RWeick/Datel-Gameboy-Pro-Action-Replay/README.md

# Datel-Gameboy-Pro-Action-Replay
Everything necessary to produce the Pro Action Replay for the Gameboy.

PCB Thickness: 0.8 mm

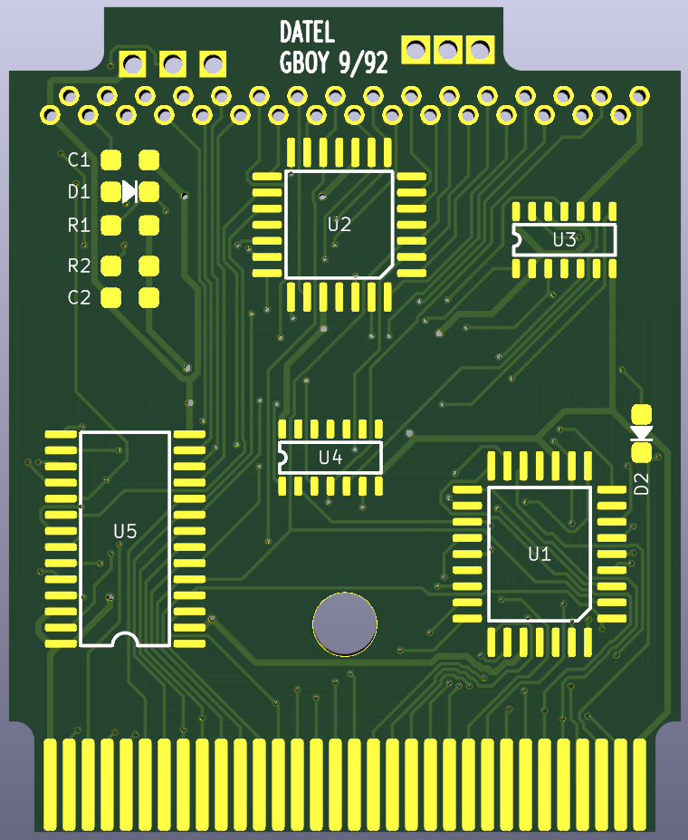
[picture p1: GBOY.png]
