RWeick/Datel-Gameboy-Pro-Action-Replay/GBOY.kicad_pcb

## KiCad design GBOY.kicad_pcb (2024-09-15)

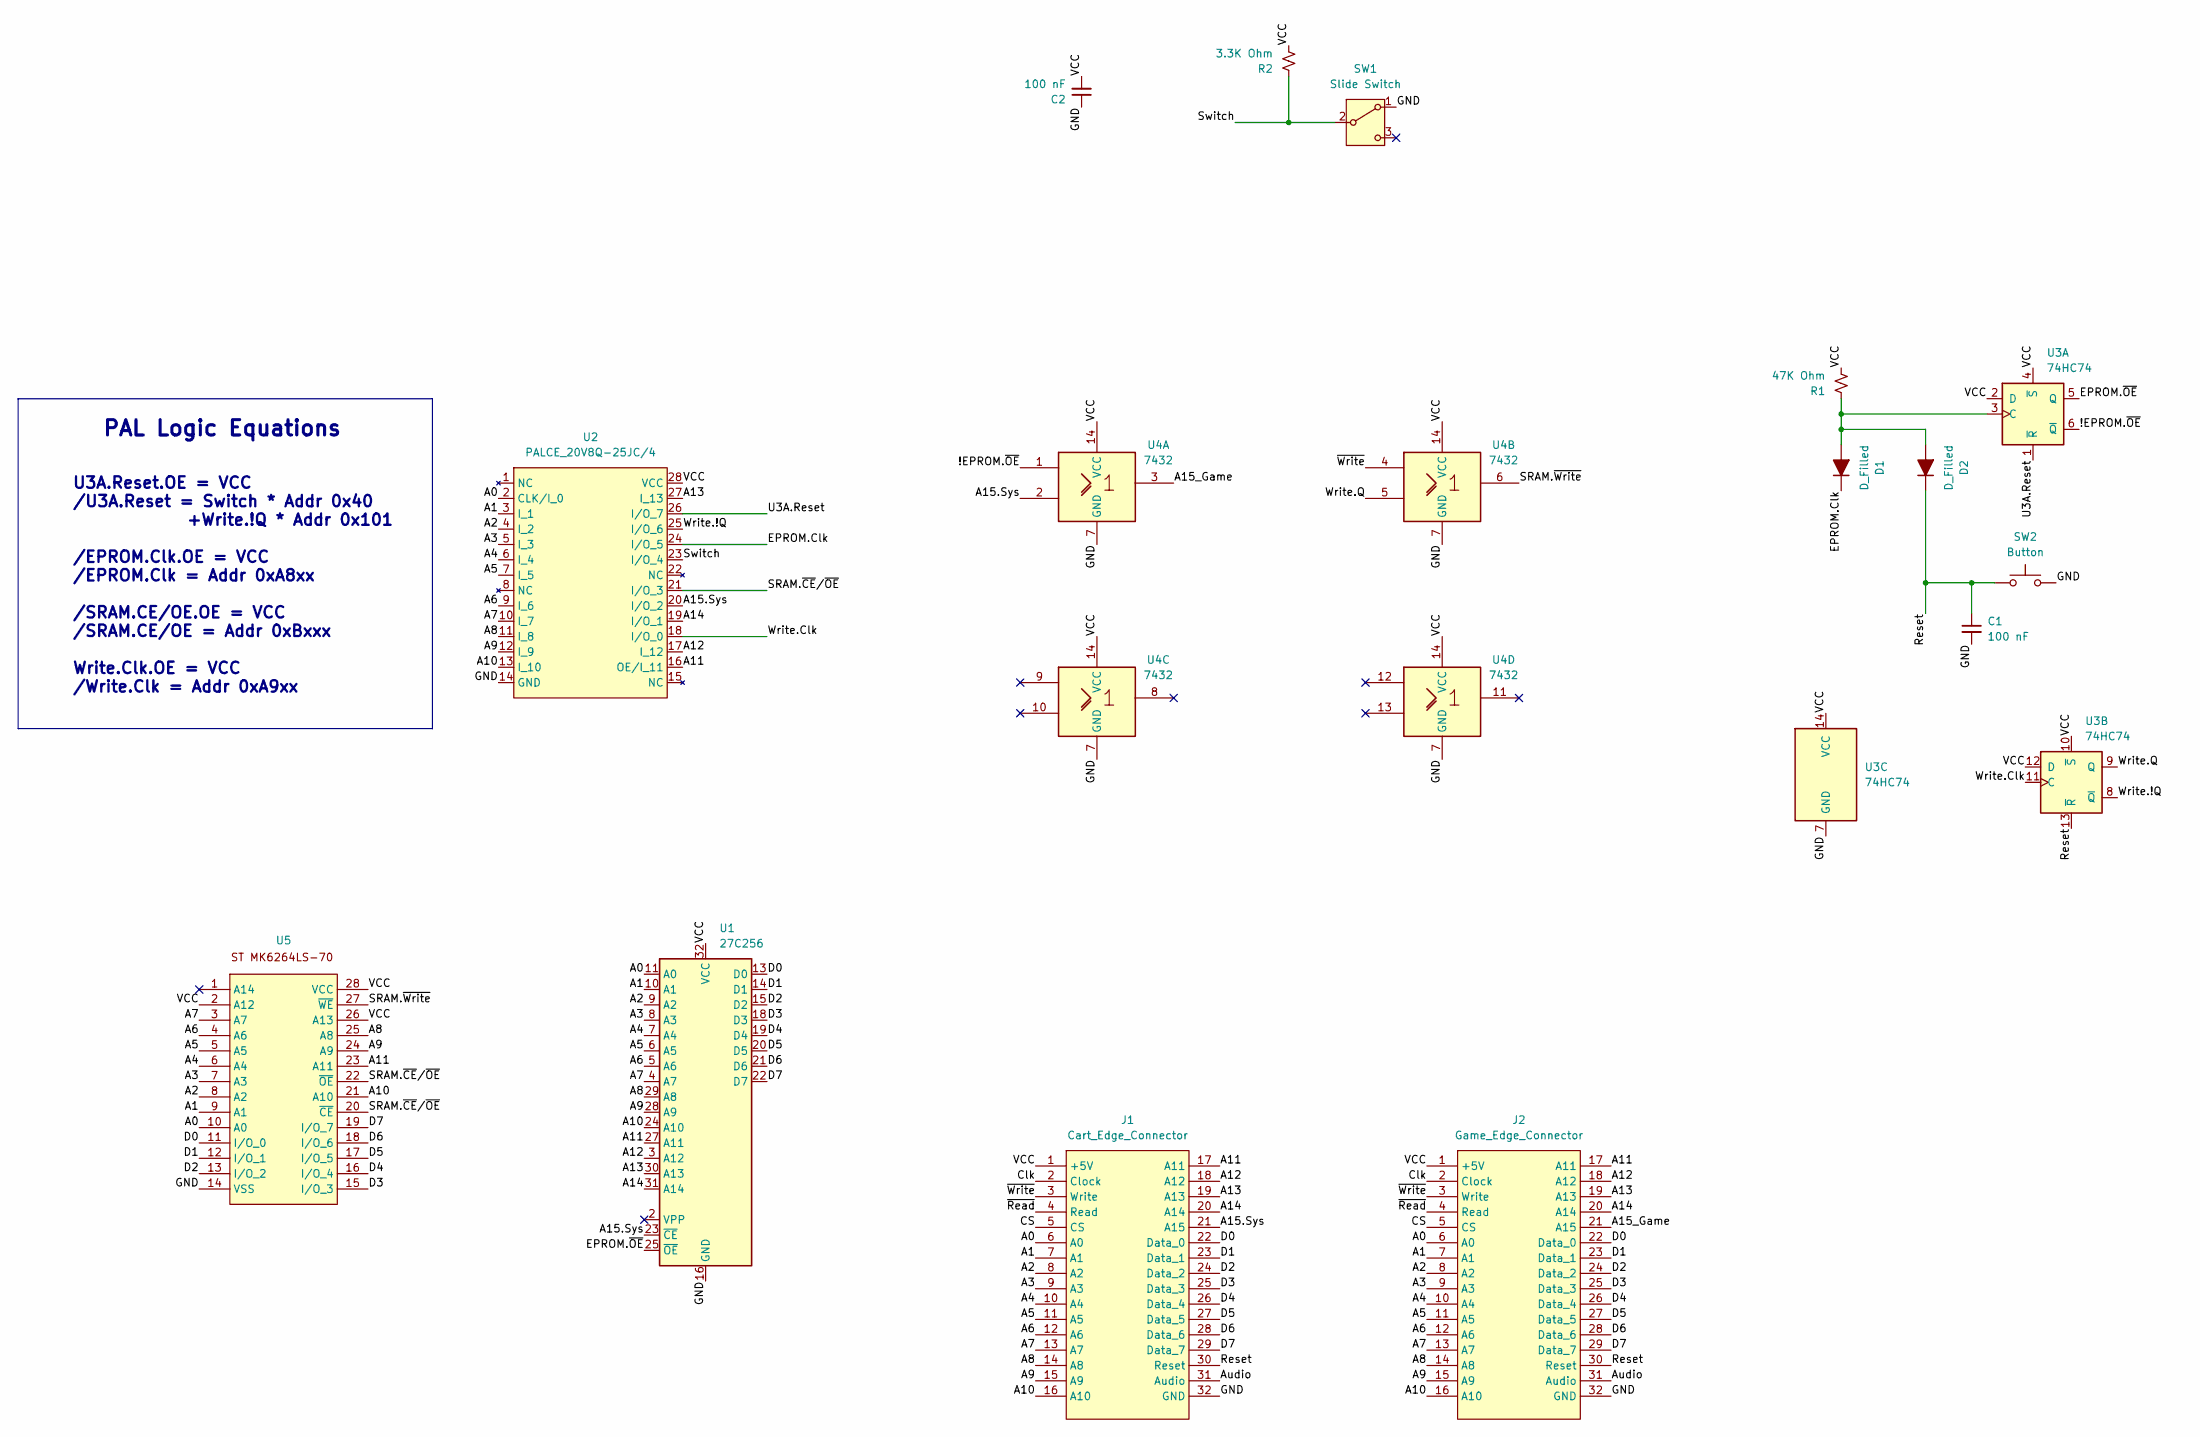
[picture p2: schematic GBOY.kicad_sch]

Parts:
C1, C2: 100 nF; 1206 SMD
D1, D2: D_Filled; 1206 SMD
J1: Cart_Edge_Connector; Edge Connector
J2: Game_Edge_Connector; Cartridge Slot
R1: 47K Ohm; 1206 SMD
R2: 3.3K Ohm; 1206 SMD
SW1: Slide Switch; Switch
SW2: Button
U1: 27C256; EPROM
U2: PALCE_20V8Q-25JC/4; PALCE
U3: 74HC74; SOIC-14
U4: 7432; SOIC-14
U5: SRAM

Connections:
/!EPROM.~OE: U3.6 (~Q), U4.1
/A0: J1.6 (A0), J2.6 (A0), U1.11 (A0), U2.2 (CLK/I_0), U5.10 (A0)
/A1: J1.7 (A1), J2.7 (A1), U1.10 (A1), U2.3 (I_1), U5.9 (A1)
/A2: J1.8 (A2), J2.8 (A2), U1.9 (A2), U2.4 (I_2), U5.8 (A2)
/A3: J1.9 (A3), J2.9 (A3), U1.8 (A3), U2.5 (I_3), U5.7 (A3)
/A4: J1.10 (A4), J2.10 (A4), U1.7 (A4), U2.6 (I_4), U5.6 (A4)
/A5: J1.11 (A5), J2.11 (A5), U1.6 (A5), U2.7 (I_5), U5.5 (A5)
/A6: J1.12 (A6), J2.12 (A6), U1.5 (A6), U2.9 (I_6), U5.4 (A6)
/A7: J1.13 (A7), J2.13 (A7), U1.4 (A7), U2.10 (I_7), U5.3 (A7)
/A8: J1.14 (A8), J2.14 (A8), U1.29 (A8), U2.11 (I_8), U5.25 (A8)
/A9: J1.15 (A9), J2.15 (A9), U1.28 (A9), U2.12 (I_9), U5.24 (A9)
/A10: J1.16 (A10), J2.16 (A10), U1.24 (A10), U2.13 (I_10), U5.21 (A10)
/A11: J1.17 (A11), J2.17 (A11), U1.27 (A11), U2.16 (OE/I_11), U5.23 (A11)
/A12: J1.18 (A12), J2.18 (A12), U1.3 (A12), U2.17 (I_12)
/A13: J1.19 (A13), J2.19 (A13), U1.30 (A13), U2.27 (I_13)
/A14: J1.20 (A14), J2.20 (A14), U1.31 (A14), U2.19 (I/O_1)
/A15.Sys: J1.21 (A15), U1.23 (~CE), U2.20 (I/O_2), U4.2
/A15_Game: J2.21 (A15), U4.3
/Audio: J1.31 (Audio), J2.31 (Audio)
/CS: J1.5 (CS), J2.5 (CS)
/Clk: J1.2 (Clock), J2.2 (Clock)
/D0: J1.22 (Data_0), J2.22 (Data_0), U1.13 (D0), U5.11 (I/O_0)
/D1: J1.23 (Data_1), J2.23 (Data_1), U1.14 (D1), U5.12 (I/O_1)
/D2: J1.24 (Data_2), J2.24 (Data_2), U1.15 (D2), U5.13 (I/O_2)
/D3: J1.25 (Data_3), J2.25 (Data_3), U1.18 (D3), U5.15 (I/O_3)
/D4: J1.26 (Data_4), J2.26 (Data_4), U1.19 (D4), U5.16 (I/O_4)
/D5: J1.27 (Data_5), J2.27 (Data_5), U1.20 (D5), U5.17 (I/O_5)
/D6: J1.28 (Data_6), J2.28 (Data_6), U1.21 (D6), U5.18 (I/O_6)
/D7: J1.29 (Data_7), J2.29 (Data_7), U1.22 (D7), U5.19 (I/O_7)
/EPROM.Clk: D1.1 (K), U2.24 (I/O_5)
/EPROM.~OE: U1.25 (~OE), U3.5 (Q)
/GND: C1.2, C2.1, J1.32 (GND), J2.32 (GND), SW1.1 (A), SW2.2, U1.16 (GND), U2.14 (GND), U3.7 (GND), U4.7 (GND), U5.14 (VSS)
/Reset: C1.1, D2.1 (K), J1.30 (Reset), J2.30 (Reset), SW2.1, U3.13 (~R)
/SRAM.~CE/~OE: U2.21 (I/O_3), U5.20 (~CE), U5.22 (~OE)
/SRAM.~Write: U4.6, U5.27 (~WE)
/Switch: R2.1, SW1.2 (B), U2.23 (I/O_4)
/U3A.Reset: U2.26 (I/O_7), U3.1 (~R)
/VCC: C2.2, J1.1 (+5V), J2.1 (+5V), R1.2, R2.2, U1.32 (VCC), U2.28 (VCC), U3.2 (D), U3.4 (~S), U3.10 (~S), U3.12 (D), U3.14 (VCC), U4.14 (VCC), U5.2 (A12), U5.26 (A13), U5.28 (VCC)
/Write.!Q: U2.25 (I/O_6), U3.8 (~Q)
/Write.Clk: U2.18 (I/O_0), U3.11 (C)
/Write.Q: U3.9 (Q), U4.5
/~Read: J1.4 (Read), J2.4 (Read)
/~Write: J1.3 (Write), J2.3 (Write), U4.4
unnamed: D1.2 (A), D2.2 (A), R1.1, U3.3 (C)

Notes on the sheet:
PAL Logic Equations
U3A.Reset.OE = VCC /U3A.Reset = Switch * Addr 0x40 +Write.!Q * Addr 0x101 /EPROM.Clk.OE = VCC /EPROM.Clk = Addr 0xA8xx /SRAM.CE/OE.OE = VCC /SRAM.CE/OE = Addr 0xBxxx Write.Clk.OE = VCC /Write.Clk = Addr 0xA9xx

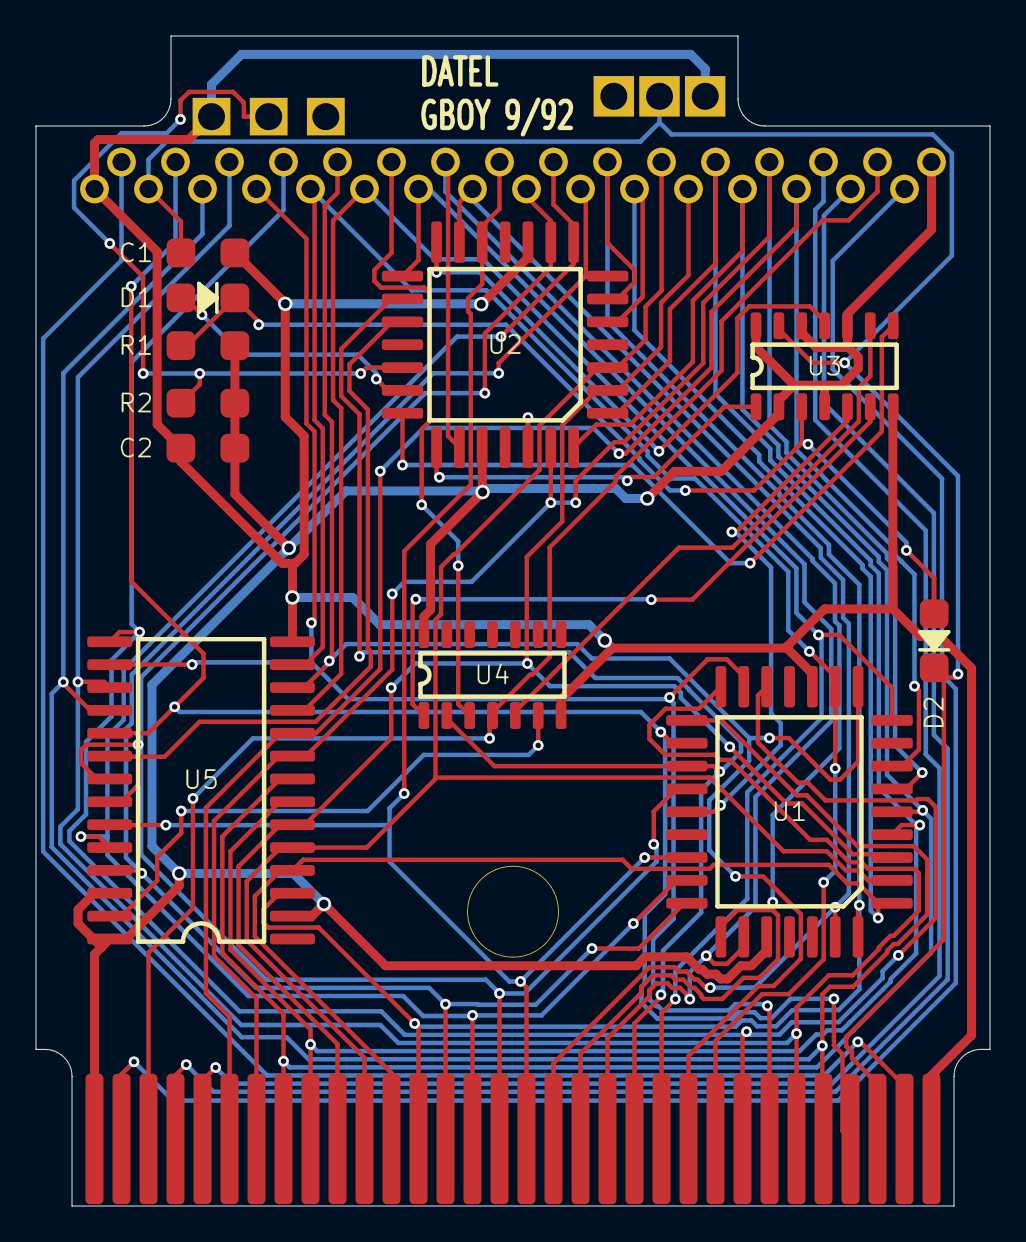
[picture p3: board GBOY.kicad_pcb from above]

Board: 2 copper layers, 53.0 x 65.0 mm, 16 parts (0 on the bottom side), 44 nets.

Other parts of the board:
Hole: Drill Hole
